FR33THYFR33THY/DIY-Latency-Tool/README.md

# DIY-Latency-Tool

## Description
Build your own external Arduino latency tool.

## Parts List
[Pushbutton Switch (Reset Button) | FB15ANEP2-FC](<https://au.mouser.com/ProductDetail/633-FB15ANEP2-FC>) <br>
[OLED Display I2C x2 | CS-ANAVI-DISPLAY-1](<https://au.mouser.com/ProductDetail/392-CSANAVIDISPLAY1>) <br>
[Latching Pushbutton Switch | IPR1FAD6](<https://au.mouser.com/ProductDetail/642-IPR1FAD6>) <br>
[Resistor 220 Ohms | MF1/4LCT52R221J](<https://au.mouser.com/ProductDetail/660-MF1-4LCT52R221J>) <br>
[KY-018 Photoresistor Module | KY-018](<https://www.ebay.com.au/itm/143933193381>) <br>
[ARDUINO LEONARDO | A000057](<https://au.mouser.com/ProductDetail/782-A000057>) <br>
[Transistor NPN BJT | 2N2222A](<https://au.mouser.com/ProductDetail/637-2N2222A>) <br>
[Micro USB Cable | 3025034-10](<https://au.mouser.com/ProductDetail/562-3025034-10>) <br>
[3 Pin Jumper Cable | 3PIN-01](<https://au.mouser.com/ProductDetail/375-3PIN-01>) <br>
[Jumper Wires | KIT-ZW-20x3](<https://au.mouser.com/ProductDetail/854-KIT-ZW-20X3>) <br>
Mouse Wired Non Optical Switches <br>
Double Sided Gel Tape <br>
Electrical Tape <br>
Soldering Iron <br>
Wire Stripper <br>
Razor Blade <br>
Multimeter <br>
Heatshrink <br>
Glue Stick <br>
Glue Gun <br>
Scissors <br>
Solder <br>
Wire

## Software
[Arduino IDE + U8g2 Plugin](https://www.arduino.cc/en/software) <br>
[Aperture Grille Black to White](https://www.aperturegrille.com/software) <br>
[Force Reflex Flash (NVIDIA-RTX Streamline)](https://github.com/NVIDIA-RTX/Streamline/tree/main) <br>
[Programming Guide Reflex (NVIDIA-RTX Streamline)](https://github.com/NVIDIA-RTX/Streamline/blob/main/docs/ProgrammingGuideReflex.md) <br>
[Nvidia Profile Inspector](https://github.com/Orbmu2k/nvidiaProfileInspector)

## Wiring Diagram
[Wiring Diagram](https://github.com/FR33THYFR33THY/DIY-Latency-Tool/blob/main/Wiring%20Diagram.png?raw=true)

## Configs
[Configs](https://github.com/FR33THYFR33THY/DIY-Latency-Tool/tree/main/Configs)

## Video
[Video](<https://youtu.be/OrdjtqZ9vZE>)

Video
