FR33THYFR33THY/DIY-Latency-Tool/Wiring Diagram.png

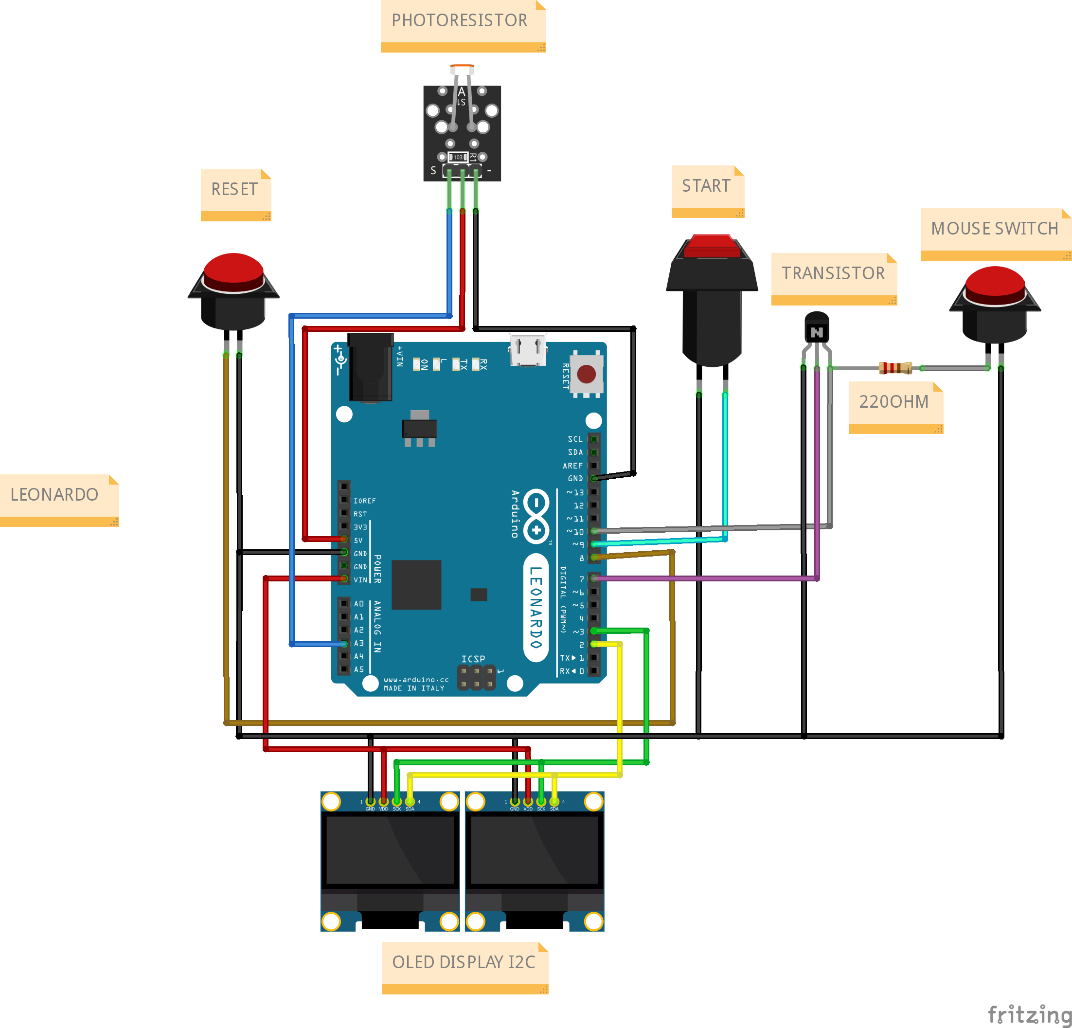
Wiring Diagram.png
